Aylo6061/PDHV/RP2040/RP2040.step

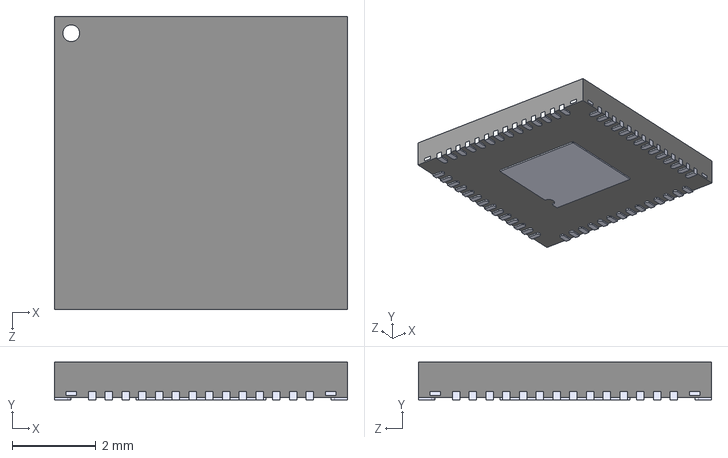
[picture p1: CAD file, 2023-03-27]
RP2040/RP2040.step
7.00 x 0.9 x 7.00 mm
