Aylo6061/PDHV/PD_HV.kicad_pcb

## KiCad design PD_HV.kicad_pcb (2023-03-29)

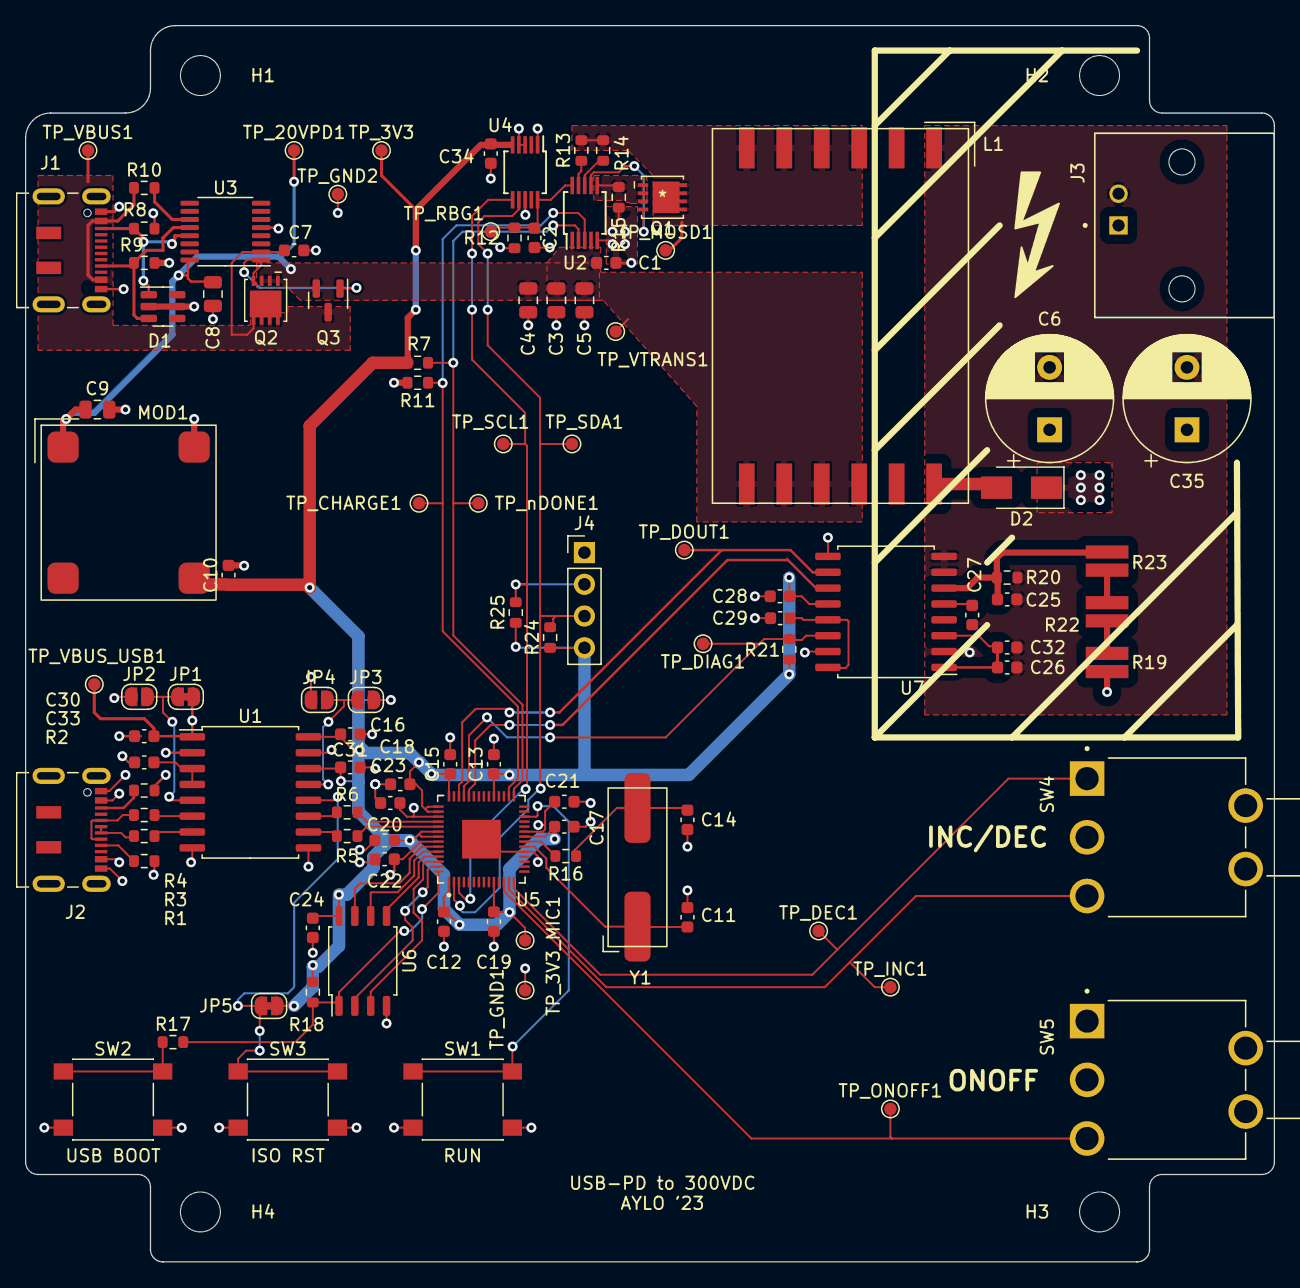
[picture p2: board PD_HV.kicad_pcb from above]

Board: 4 copper layers, 100.0 x 99.0 mm, 112 parts (0 on the bottom side), 61 nets.

Parts:
C1: 10u; C_0603_1608Metric
C2: 100pF; C_0603_1608Metric
C3, C4, C5: 22uF; C_0805_2012Metric
C6, C35: 3.3u; CP_Radial_D10.0mm_P5.00mm
C7, C12, C21, C26, C28: 1uF; C_0603_1608Metric
C8, C9: 10uF; C_0805_2012Metric
C10: 22uF; C_0603_1608Metric
C11, C14: 27p; C_0603_1608Metric
C13, C15, C16, C17, C18, C19, C20, C22, C23, C24, C27, C29, C30, C31, C32, C33, C34: 100nF; C_0603_1608Metric
C25: 1nF; C_0603_1608Metric
D1: ESDA6V1BC6; SOT-23-6
D2: 600V; D_SMA
H1, H2, H3, H4: MountingHole; MountingHole_3.2mm_M3
J1, J2: USB_C_Receptacle; USB_C_Receptacle_JAE_DX07S016JA1R1500
J3: Conn_Coaxial; TE_5227161-2
J4: Conn_01x04_Male; PinHeader_1x04_P2.54mm_Vertical
JP1, JP5: SolderJumper-2_P1.3mm_Bridged_RoundedPad1.0x1.5mm
JP2, JP3, JP4: SolderJumper-2_P1.3mm_Open_RoundedPad1.0x1.5mm
L1: DA2034-AL
MOD1: K7803JT-500R3-LB; MORNSUN_K7803JT-500R3-LB
Q1: AON7296; DFN3X3A_8L_EPA1_P_AOS
Q2: AON7410; DFN3X3A_8L_EPA1_P_AOS
Q3: AO3400A; SOT-23
R1, R2, R8, R9: 5.1k; R_0603_1608Metric
R3, R4, R5, R6: 24; R_0603_1608Metric
R7, R11, R18: 10k; R_0603_1608Metric
R10: 100k; R_0603_1608Metric
R12: R; R_0603_1608Metric
R13: 12k 1%; R_0603_1608Metric
R14: 43k 1%; R_0603_1608Metric
R15: .024 Ohm 1% 1/3W; R_0603_1608Metric
R16, R17, R20: 1k; R_0603_1608Metric
R19, R22, R23: 100k; RESC1632X60N
R21, R24, R25: 4k7; R_0603_1608Metric
SW1, SW2, SW3: SW_SPST; SW_SPST_PTS645
SW4: MOM-OFF-MOM; SW_100SP1T2B4M6QE
SW5: SW_SPDT; SW_100SP1T2B4M6QE
TP_3V3, TP_3V3_MIC1, TP_20VPD1: TestPoint; TestPoint_Pad_D1.0mm
TP_CHARGE1: TestPoint; TestPoint_Pad_D1.0mm
TP_DEC1: TestPoint; TestPoint_Pad_D1.0mm
TP_DIAG1: TestPoint; TestPoint_Pad_D1.0mm
TP_DOUT1: TestPoint; TestPoint_Pad_D1.0mm
TP_GND1, TP_GND2: TestPoint; TestPoint_Pad_D1.0mm
TP_INC1: TestPoint; TestPoint_Pad_D1.0mm
TP_MOSD1: TestPoint; TestPoint_Pad_D1.0mm
TP_ONOFF1: TestPoint; TestPoint_Pad_D1.0mm
TP_RBG1: TestPoint; TestPoint_Pad_D1.0mm
TP_SCL1: TestPoint; TestPoint_Pad_D1.0mm
TP_SDA1: TestPoint; TestPoint_Pad_D1.0mm
TP_VBUS1: TestPoint; TestPoint_Pad_D1.0mm
TP_VBUS_USB1: TestPoint; TestPoint_Pad_D1.0mm
TP_VTRANS1: TestPoint; TestPoint_Pad_D1.0mm
TP_nDONE1: TestPoint; TestPoint_Pad_D1.0mm
U1: SOIC-16W_7.5x10.3mm_P1.27mm
U2: LT3750A; MSOP-10_3x3mm_P0.5mm
U3: IP2721; TSSOP-16_4.4x5mm_P0.65mm
U4: AD5170BRMZ2.5; MSOP-10_3x3mm_P0.5mm
U5: RP2040; QFN40P700X700X90-57N
U6: W25Q128JVS; SOIC-8_5.23x5.23mm_P1.27mm
U7: AMC3336-Q1; SOIC-16W_7.5x10.3mm_P1.27mm
Y1: Crystal; ABLS-2SMD-XTAL

Connections:
+1V1: C21.1, C22.1, C23.1, U5.23 (DVDD), U5.45 (VREG_VOUT), U5.50 (DVDD)
+3.3V: C10.1, C12.1, C13.1, C15.1, C16.1, C17.1, C18.1, C19.1, C20.1, C24.1, C28.2, C31.1, C34.1, J4.4, JP3.2 (B), JP5.2 (B), MOD1.3 (+Vo_3V3), R7.1, R18.1, R21.1, R24.1, R25.1, TP_3V3.1, TP_3V3_MIC1.1, U1.14 (VDD2), U1.16 (VBUS2), U4.5 (VDD), U5.1 (IOVDD), U5.10 (IOVDD), U5.22 (IOVDD), U5.33 (IOVDD), U5.42 (IOVDD), U5.43 (ADC_AVDD), U5.44 (VREG_VIN), U5.48 (USB_VDD), U5.49 (IOVDD), U6.8 (VCC), U7.12 (VDD)
+20V_USBPD: C1.1, C3.1, C4.1, C5.1, C8.1, C9.1, L1.7, L1.8, L1.9, L1.10, MOD1.1 (+Vin), Q2.1 (S), Q2.2 (S), Q2.3 (S), Q3.2 (S), TP_20VPD1.1, TP_VTRANS1.1, U2.1 (VTRANS), U2.4 (Vcc), U3.16 (VBUS)
+HV: C6.1, C35.1, D2.1 (K), J3.1 (In), R19.1
+VBUS_USB: C30.1, J2.A4 (VBUS), J2.A9 (VBUS), J2.B4 (VBUS), J2.B9 (VBUS), JP1.2 (B), TP_VBUS_USB1.1, U1.1 (VBUS1)
/HVMeasurement/CLKIN: U5.38 (GPIO26/ADC0), U7.11 (CLKIN)
/HVMeasurement/DIAG: R21.2, TP_DIAG1.1, U5.39 (GPIO27/ADC1), U7.14 (DIAG)
/HVMeasurement/DOUT: TP_DOUT1.1, U5.40 (GPIO28/ADC2), U7.10 (DOUT)
/HV_Flyback/CHARGE: R11.1, TP_CHARGE1.1, U2.3 (CHARGE), U5.30 (GPIO19)
/HV_Flyback/RBG: C2.1, R12.1, TP_RBG1.1, U2.10 (RBG), U4.10 (W)
/HV_Flyback/nDone: R7.2, TP_nDONE1.1, U2.2 (nDONE), U5.29 (GPIO18)
/ISO_USB/HOST_DN: J2.A7 (D-), J2.B7 (D-), R4.1
/ISO_USB/HOST_DP: J2.A6 (D+), J2.B6 (D+), R3.1
/ISO_USB/ISO_DN: R6.2, U5.46 (USB_DM)
/ISO_USB/ISO_DP: R5.2, U5.47 (USB_DP)
/ISO_USB/PIN: JP5.1 (A), SW3.1 (A), U1.12 (PIN)
/ISO_USB/VDD1: C33.1, U1.3 (VDD1), U1.4 (PDEN)
/RP2040/DEC: SW4.1, TP_DEC1.1, U5.14 (GPIO11)
/RP2040/INC: SW4.3, TP_INC1.1, U5.13 (GPIO10)
/RP2040/ONOFF: SW5.3, TP_ONOFF1.1, U5.12 (GPIO9)
/RP2040/QSPI_SCLK: U5.52 (QSPI_SCLK), U6.6 (CLK)
/RP2040/QSPI_SD0: U5.53 (QSPI_SD0), U6.5 (DI(IO0))
/RP2040/QSPI_SD1: U5.55 (QSPI_SD1), U6.2 (DO(IO1))
/RP2040/QSPI_SD2: U5.54 (QSPI_SD2), U6.3 (IO2)
/RP2040/QSPI_SD3: U5.51 (QSPI_SD3), U6.7 (IO3)
/RP2040/QSPI_SS: R17.2, R18.2, U5.56 (QSPI_CSN), U6.1 (~CS)
/RP2040/RUN: SW1.1 (A), U5.26 (RUN)
/RP2040/SCL: J4.2, R25.2, TP_SCL1.1, U4.6 (SCL), U5.3 (GPIO1)
/RP2040/SDA: J4.3, R24.2, TP_SDA1.1, U4.7 (SDA), U5.2 (GPIO0)
/RP2040/nUSB_BOOT: R17.1, SW2.1 (A)
/USBPD_IN/CC1: D1.1 (TVS1), J1.A5 (CC1), R8.1, U3.13 (CC1)
/USBPD_IN/CC2: D1.3 (TVS2), J1.B5 (CC2), R9.1, U3.12 (CC2)
/USBPD_IN/VBUSG: Q2.4 (G), Q3.1 (G), U3.1 (VBUSG)
GND: C1.2, C2.2, C3.2, C4.2, C5.2, C7.2, C8.2, C9.2, C10.2, C11.2, C12.2, C13.2, C14.2, C15.2, C16.2, C17.2, C18.2, C19.2, C20.2, C21.2, C22.2, C23.2, C24.2, C28.1, C29.1, C31.2, C34.2, D1.2 (COM), D1.5 (COM), J1.A1 (GND), J1.A12 (GND), J1.B1 (GND), J1.B12 (GND), J4.1, JP4.1 (A), MOD1.4 (GND), R8.2, R9.2, R11.2, R12.2, R15.2, SW1.2 (B), SW2.2 (B), SW3.2 (B), SW4.2, SW5.2, TP_GND1.1, TP_GND2.1, U1.9 (GND2), U1.15 (GND2), U2.5 (GND), U3.5 (GND), U4.1 (B), U4.3 (AD0), U4.4 (GND), U4.8 (AD1), U5.19 (TESTEN), U5.57 (GND), U6.4 (GND), U7.9 (GND), U7.15 (DCDC_GND)
GND1: C30.2, C33.2, J2.A1 (GND), J2.A12 (GND), J2.B1 (GND), J2.B12 (GND), JP2.1 (A), R1.2, R2.2, U1.2 (GND1), U1.8 (GND1)
GND2: C6.2, C25.2, C26.1, C27.1, C32.2, C35.2, J3.2 (Ext), L1.1, R20.2, U7.2 (DCDC_HGND), U7.7 (INN), U7.8 (HGND)
unnamed: C11.1, U5.20 (XIN), Y1.1
unnamed: C14.1, R16.1, Y1.2
unnamed: C25.1, R20.1, R23.2, U7.6 (INP)
unnamed: C26.2, C32.1, U7.1 (DCDC_OUT), U7.3 (HLDO_IN)
unnamed: C27.2, U7.5 (HLDO_OUT)
unnamed: C29.2, U7.13 (LDO_OUT), U7.16 (DCDC_IN)
unnamed: D2.2 (A), L1.12
unnamed: J2.A5 (CC1), R2.1
unnamed: J2.B5 (CC2), R1.1
unnamed: JP1.1 (A), JP2.2 (B), U1.5 (SPU)
unnamed: JP3.1 (A), JP4.2 (B), U1.13 (SPD)
unnamed: L1.3, L1.4, L1.5, L1.6, Q1.5 (D), Q1.6 (D), Q1.7 (D), Q1.8 (D), R13.2, R14.2, TP_MOSD1.1
unnamed: Q1.1 (S), Q1.2 (S), Q1.3 (S), R15.1, U2.6 (SOURCE)
unnamed: Q1.4 (G), U2.7 (GATE)
unnamed: R3.2, U1.7 (UD+)
unnamed: R4.2, U1.6 (UD-)
unnamed: R5.1, U1.10 (DD+)
unnamed: R6.1, U1.11 (DD-)
unnamed: R10.2, U3.11 (SEL)
unnamed: R13.1, U2.9 (RVOUT)
unnamed: R14.1, U2.8 (RDCM)
unnamed: R16.2, U5.21 (XOUT)
unnamed: R19.2, R22.1
unnamed: R22.2, R23.1
VBUS: C7.1, J1.A4 (VBUS), J1.A9 (VBUS), J1.B4 (VBUS), J1.B9 (VBUS), Q2.5 (D), Q2.6 (D), Q2.7 (D), Q2.8 (D), Q3.3 (D), R10.1, TP_VBUS1.1, U3.2 (VIN)
