Aylo6061/PDHV/(commit log)

2023-03-27 inial commit of mostly done project
    [HVMeausrement.kicad_sch, HV_Flyback.kicad_sch, ISO_USB.kicad_sch, PD_HV.kicad_pcb, PD_HV.kicad_sch, PD_HV_bom_.csv, RP2040.step, USBPD_IN.kicad_sch]
2023-03-29 finished routing, sending to fab
    [HVMeausrement.kicad_sch, HV_Flyback.kicad_sch, ISO_USB.kicad_sch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]
